andresR8/Robotics4Control/README.md

# Robotics4Control
A mini-sized robot for investigation in robotics and control systems
more info at: http://www.coffeebrain.org/wiki/index.php?title=Robotics_4_Control
