andresR8/Robotics4Control/HardwareFiles/3D/Sensors.stl

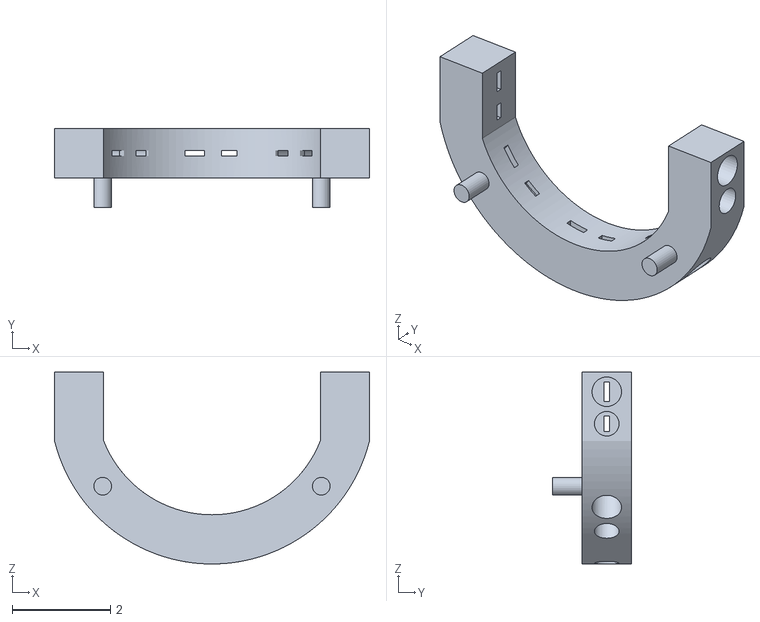
[picture p1: CAD file, 2016-05-07]
HardwareFiles/3D/Sensors.stl
6.40 x 1.60 x 3.90
