andresR8/Robotics4Control/HardwareFiles/3D/MotorHolder.stl

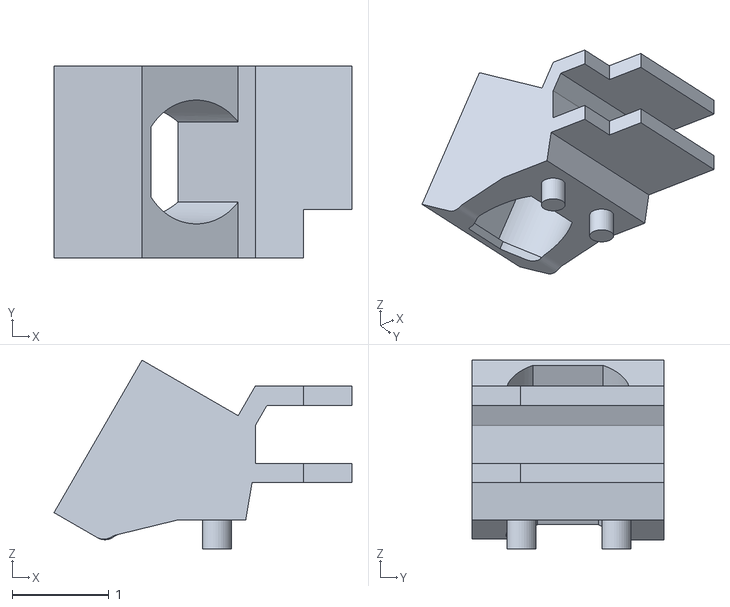
[picture p2: CAD file, 2016-05-07]
HardwareFiles/3D/MotorHolder.stl
3.08 x 1.99 x 1.95
