andresR8/Robotics4Control/HardwareFiles/3D/MotorHolder_MIR.stl

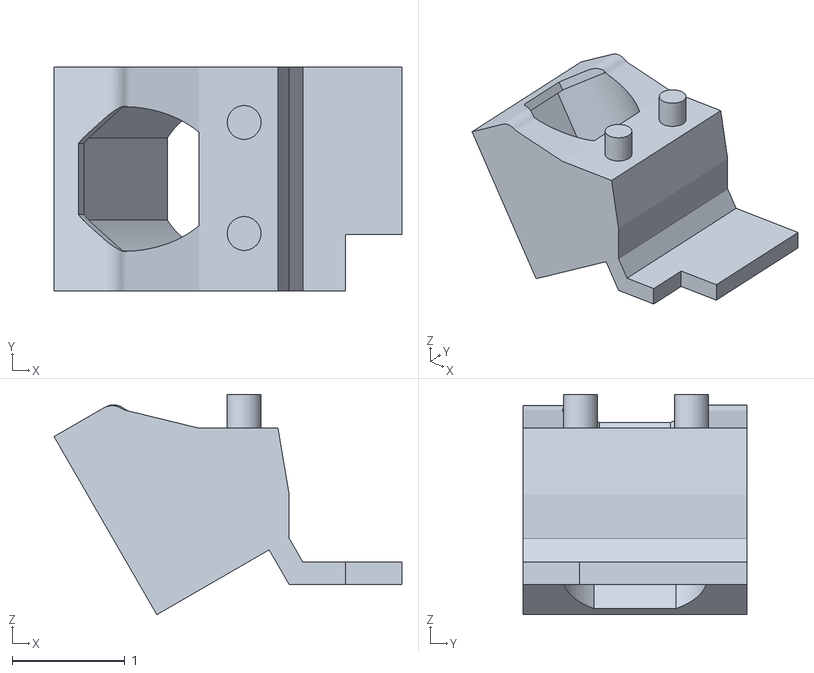
[picture p3: CAD file, 2016-05-07]
HardwareFiles/3D/MotorHolder_MIR.stl
3.08 x 1.99 x 1.95
