andresR8/Robotics4Control/SoftwareFiles/Programmer/install1.PNG

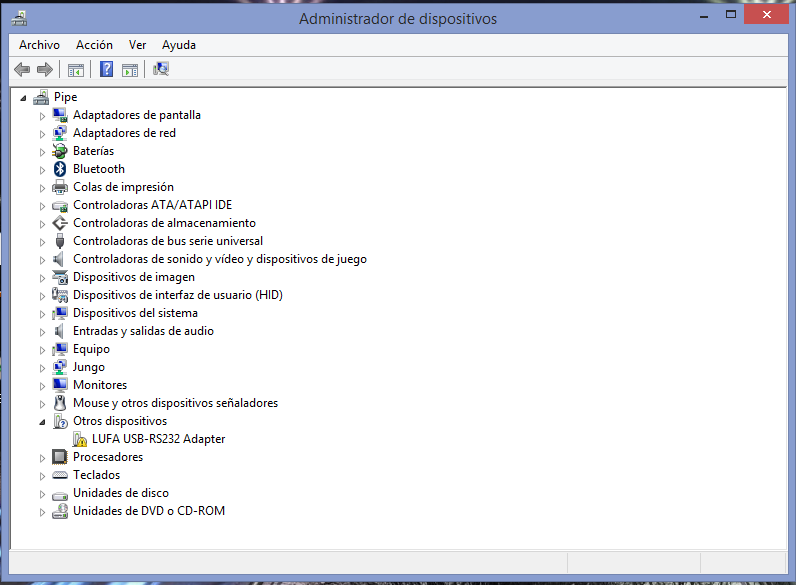
SoftwareFiles/Programmer/install1.PNG
