andresR8/Robotics4Control/SoftwareFiles/Programmer/install2.PNG

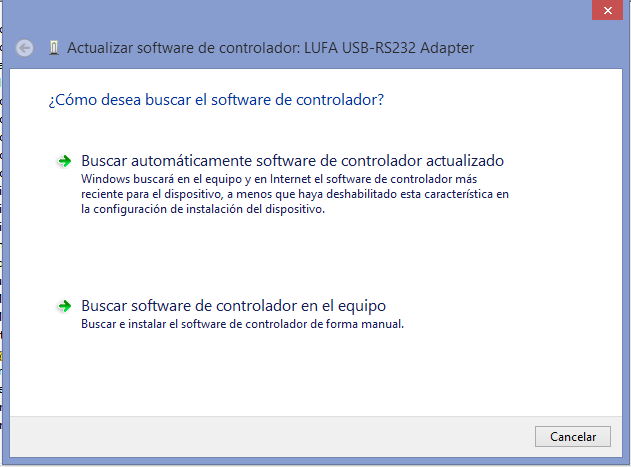
SoftwareFiles/Programmer/install2.PNG
