andresR8/Robotics4Control/SoftwareFiles/Programmer/install3.PNG

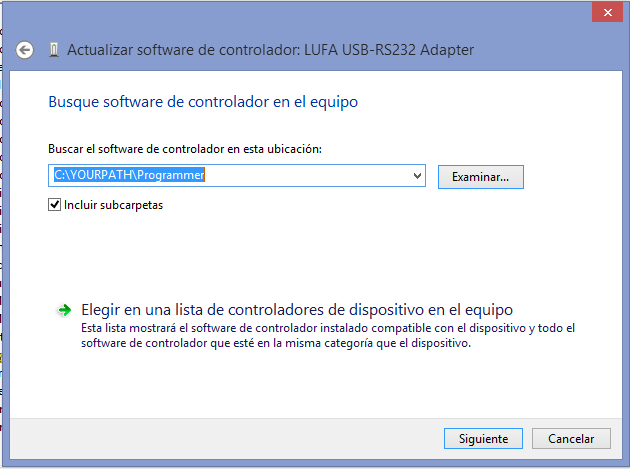
SoftwareFiles/Programmer/install3.PNG
