andresR8/Robotics4Control/SoftwareFiles/Programmer/install4.PNG

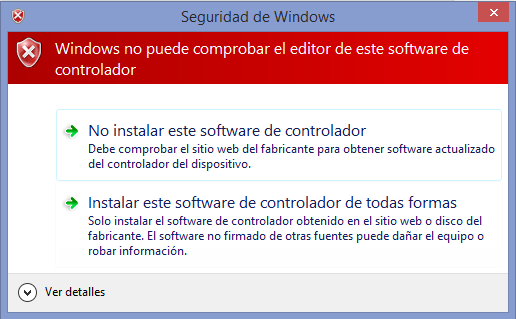
SoftwareFiles/Programmer/install4.PNG
