andresR8/Robotics4Control/SoftwareFiles/Programmer/install5.PNG

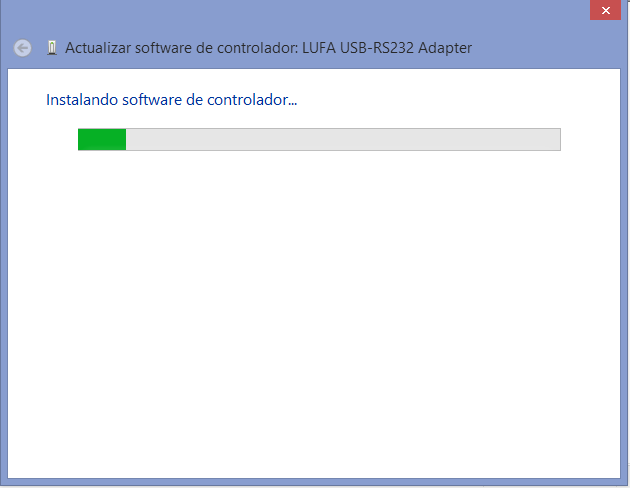
SoftwareFiles/Programmer/install5.PNG
