andresR8/Robotics4Control/SoftwareFiles/Programmer/install6.PNG

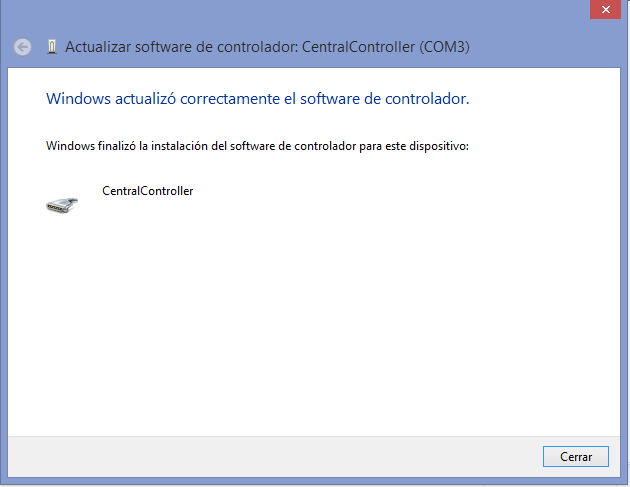
SoftwareFiles/Programmer/install6.PNG
