andresR8/Robotics4Control/SoftwareFiles/Programmer/install7.PNG

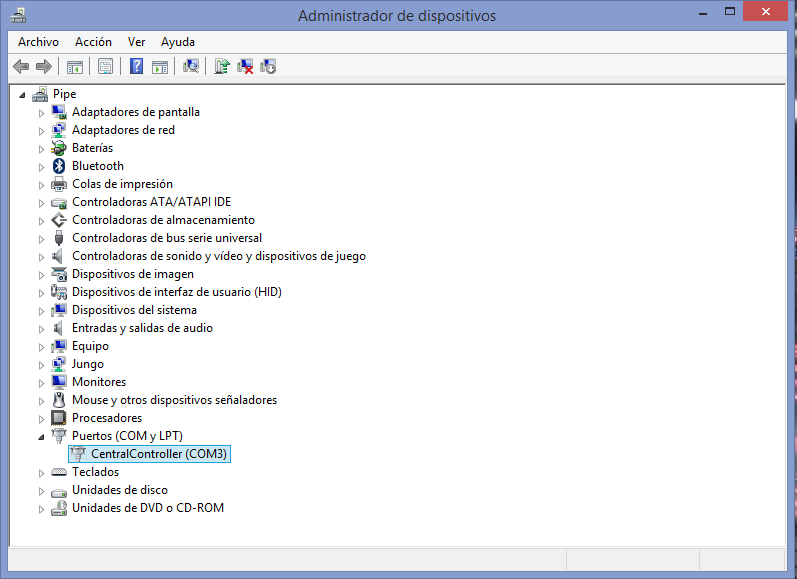
SoftwareFiles/Programmer/install7.PNG
