andresR8/Robotics4Control/HardwareFiles/MainBoard/MainBoardSch.pdf

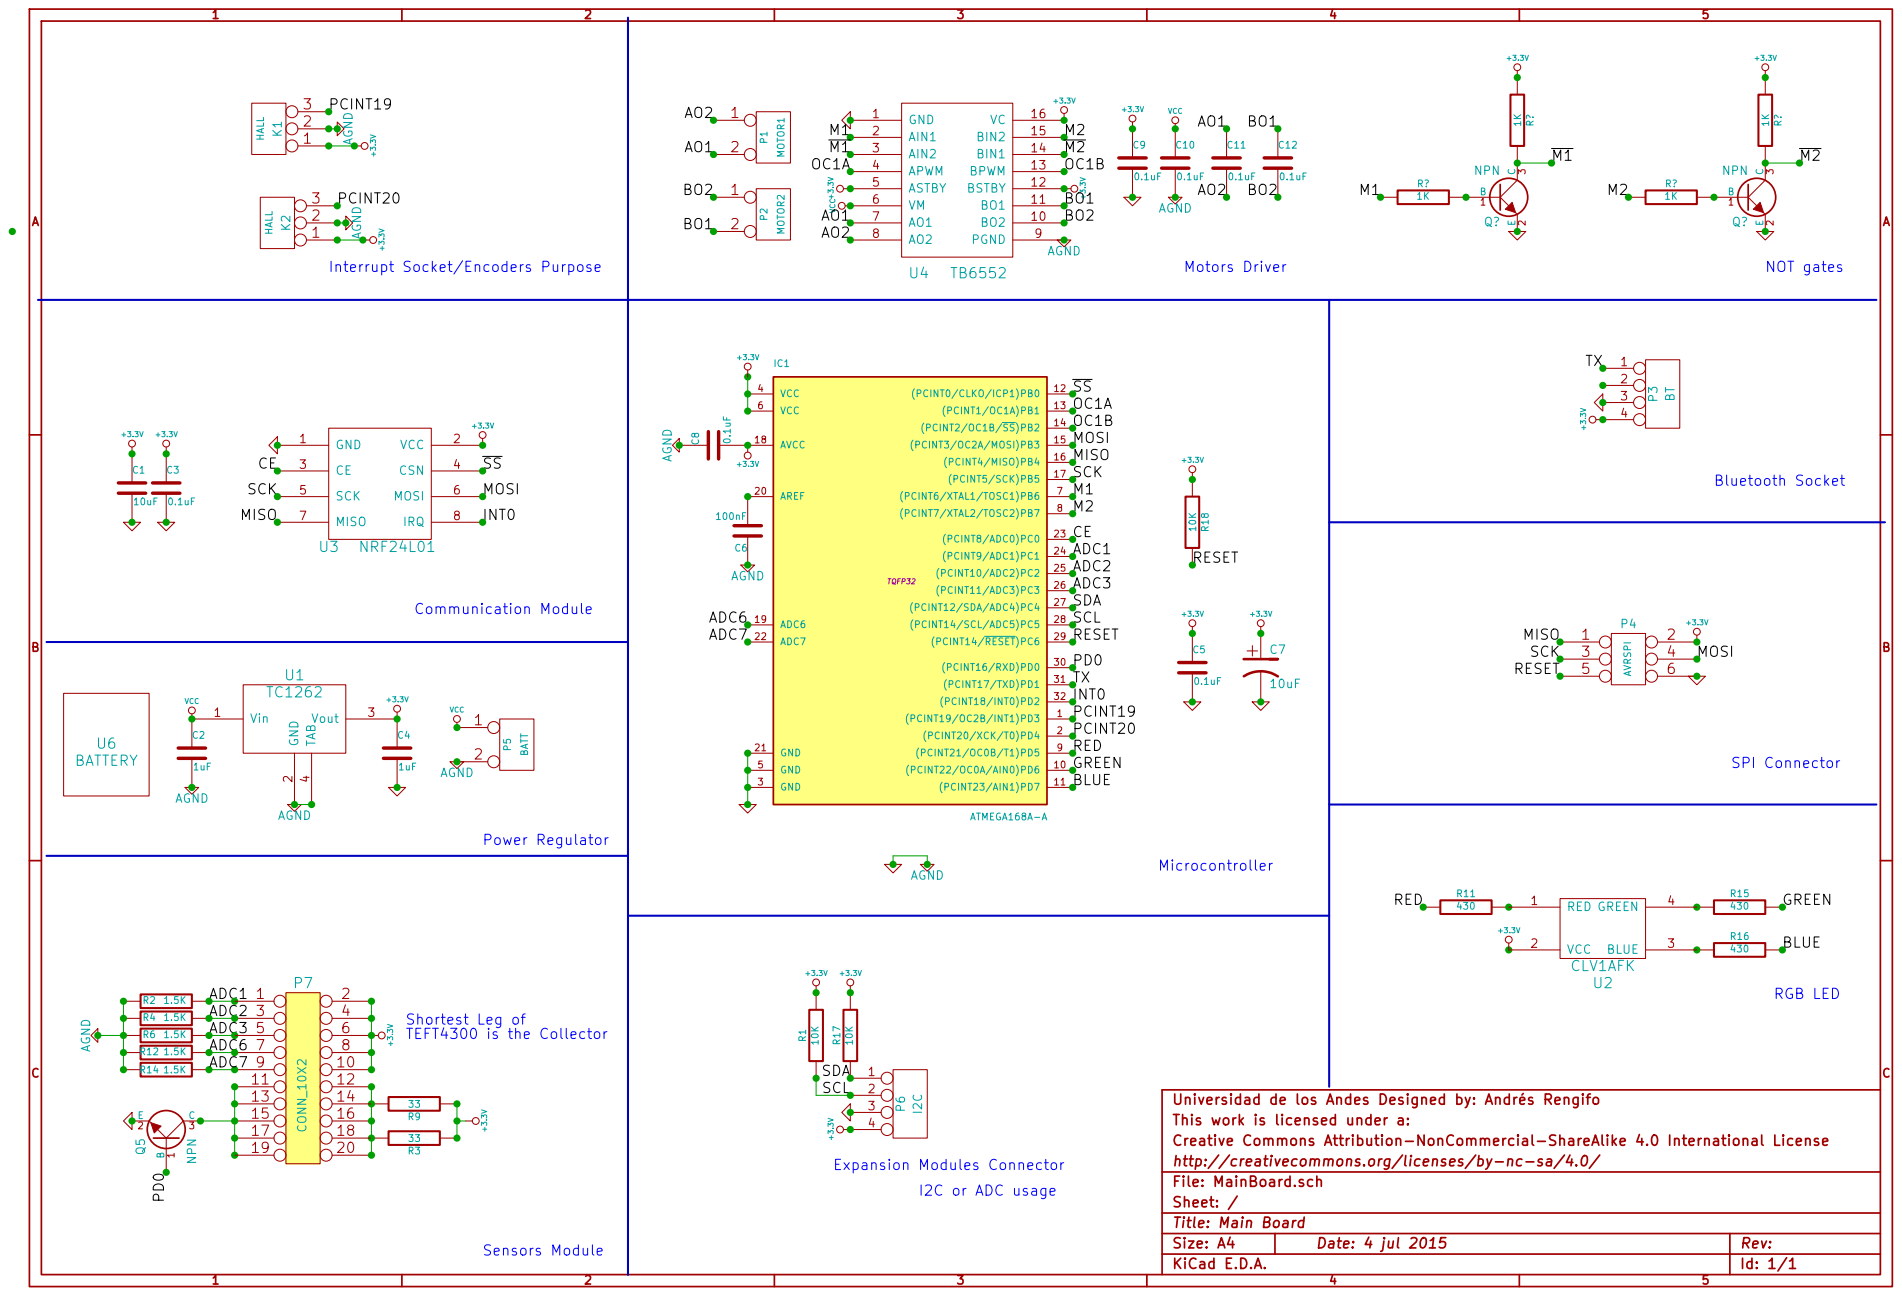
[picture p11: page 1]

4 U1 TC1262 GND 1 AIN1 2 AIN2 3 APWM 4 ASTBY 5 VM 6 AO1 7 AO2 8 PGND 9 BO2 10 BO1 11 BSTBY 12 BPWM 13 BIN1 14 BIN2 15 VC 16 U4 TB6552

Interrupt Socket/Encoders Purpose

ADC2 3 | 4
ADC3 5 | 6
ADC6 7 | 8
9 | 10

Creative Commons Attribution-NonCommercial-ShareAlike 4.0 International License This work is licensed under a: Universidad de los Andes Designed by: Andrés Rengifo

http://creativecommons.org/licenses/by-nc-sa/4.0/
Id: 1/1 Title: Main Board File: MainBoard.sch Sheet: /
