andresR8/Robotics4Control/HardwareFiles/CentralControllerBoard/ProgramerSch.pdf

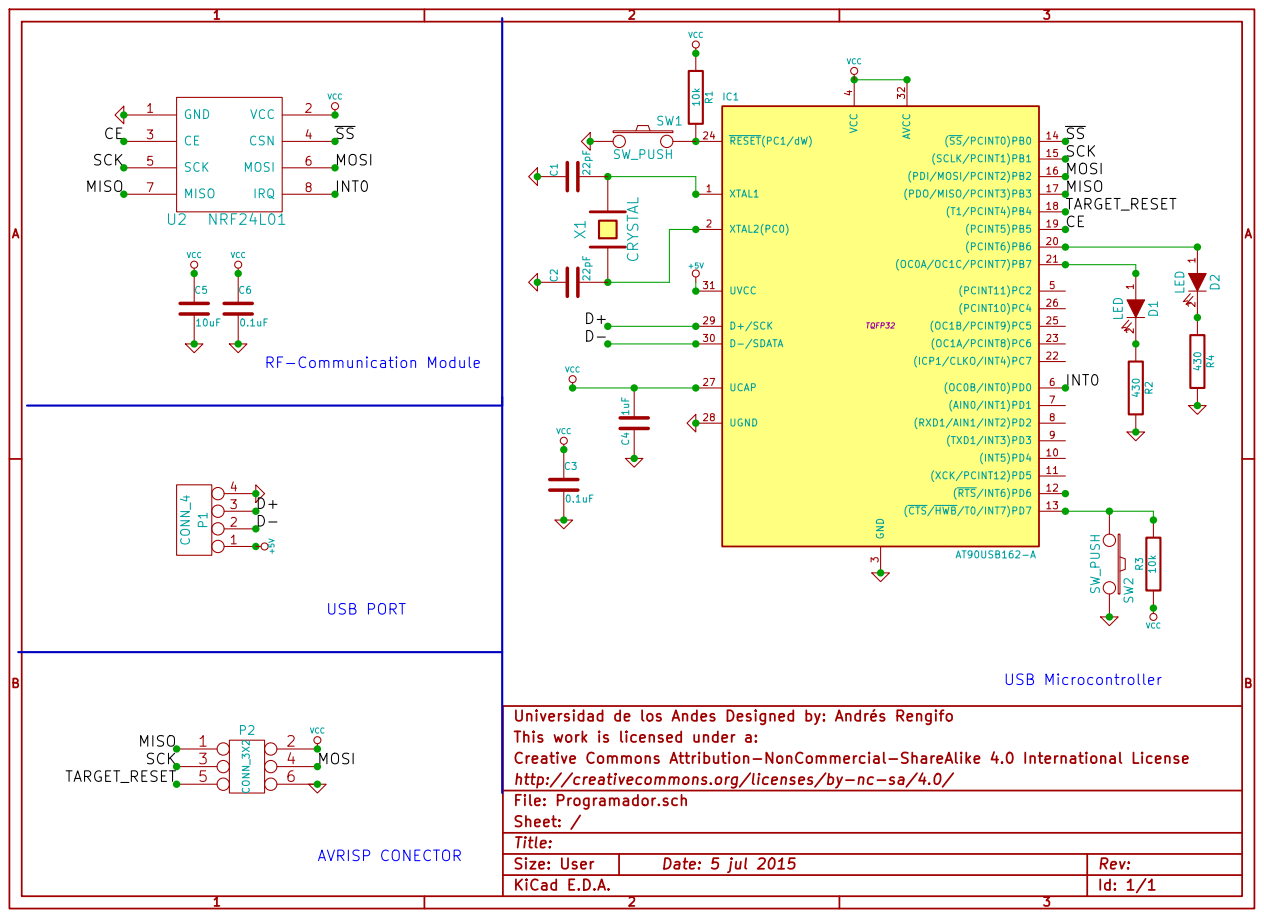
[picture p12: page 1]

1 2 D2 LED 430 R4 R3 10k VCC 1 2 D1 LED 430 R2 +5V X1 CRYSTAL C122pF C222pF

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

http://creativecommons.org/licenses/by-nc-sa/4.0/
Id: 1/1 Title: File: Programador.sch
Sheet: /

Size: User | | Rev:
KiCad E.D.A.
