andresR8/Robotics4Control/HardwareFiles/LipoCharger/ChargerBrd.pdf

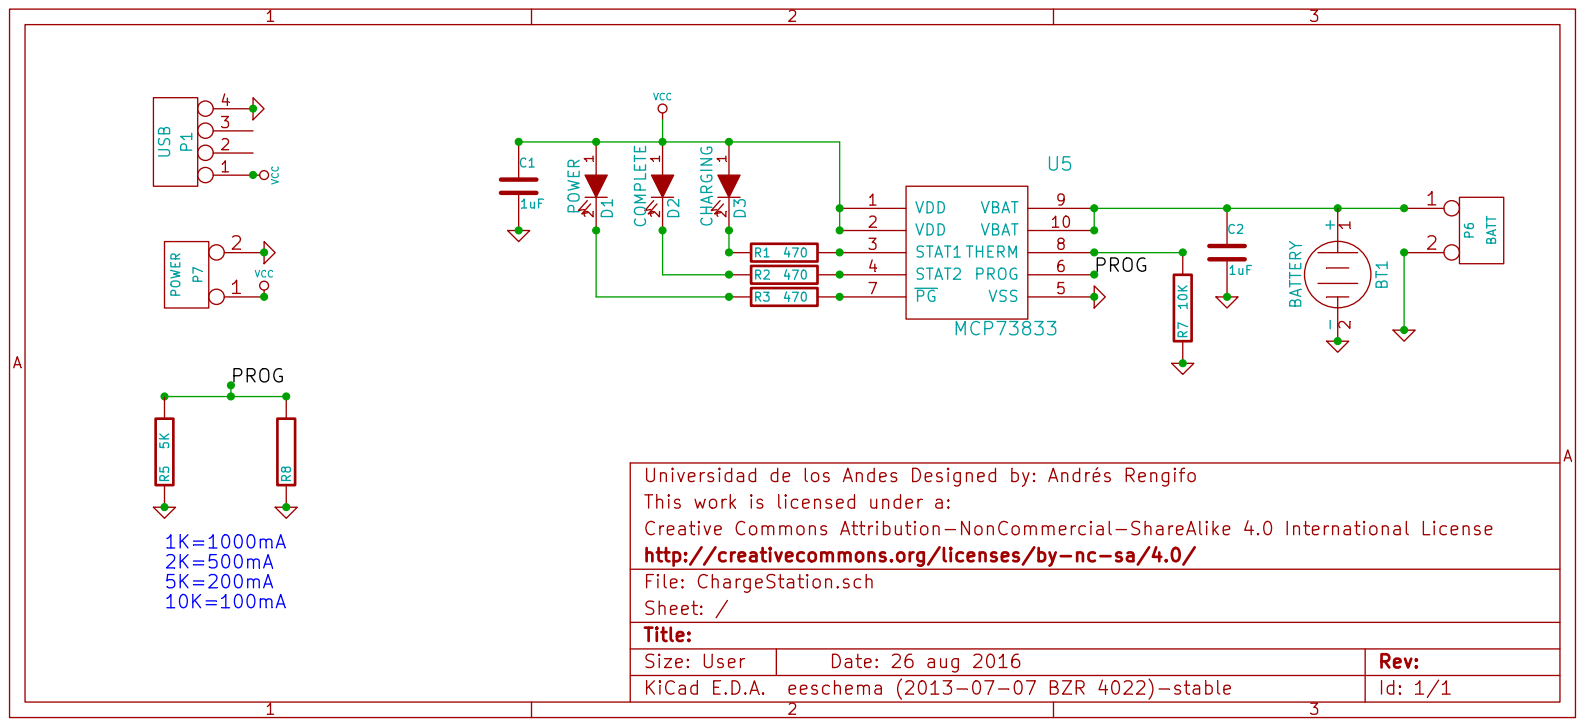
[picture p13: page 1]
