andresR8/Robotics4Control/HardwareFiles/MainBoard/MainBoardBackBrd.pdf

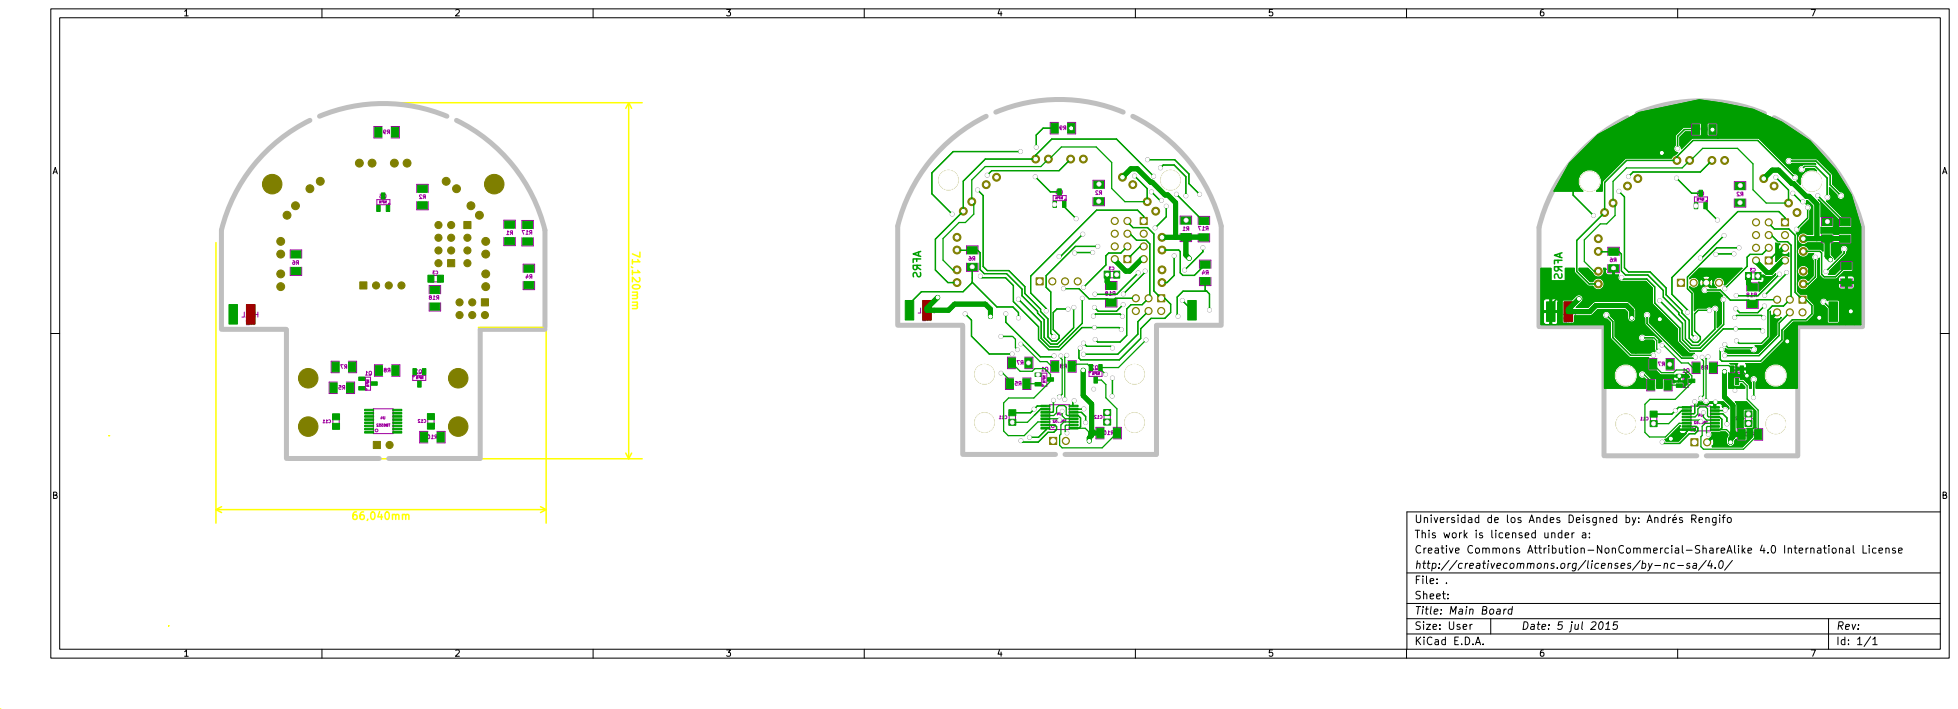
[picture p14: page 1]
