andresR8/Robotics4Control/HardwareFiles/MainBoard/MainBoardFrontBrd.pdf

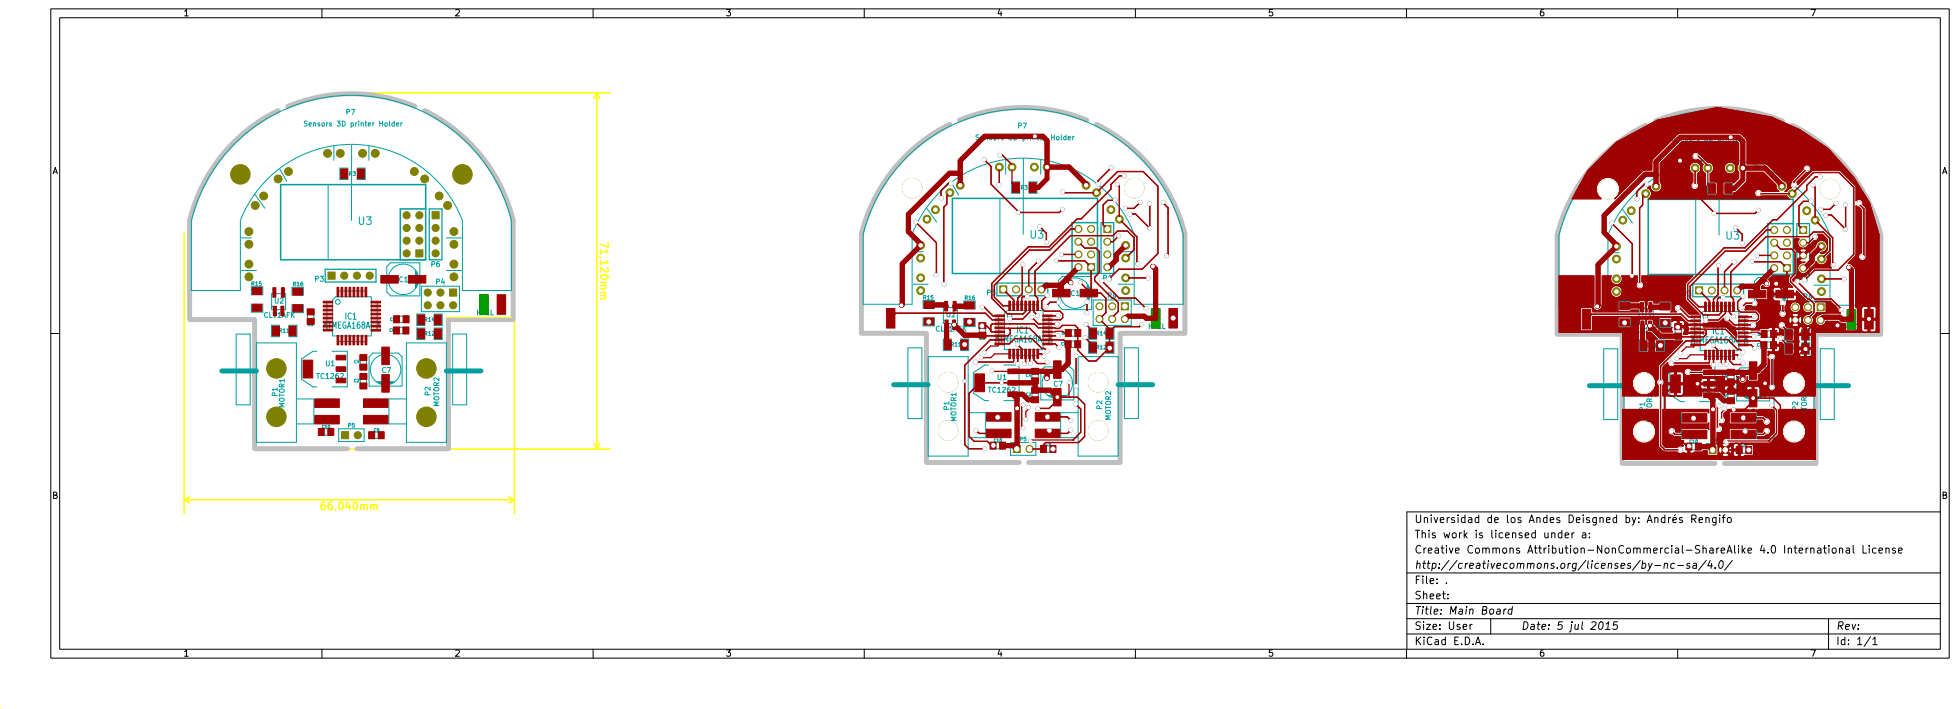
[picture p15: page 1]
