andresR8/Robotics4Control/HardwareFiles/CentralControllerBoard/ProgramerBrdBack.pdf

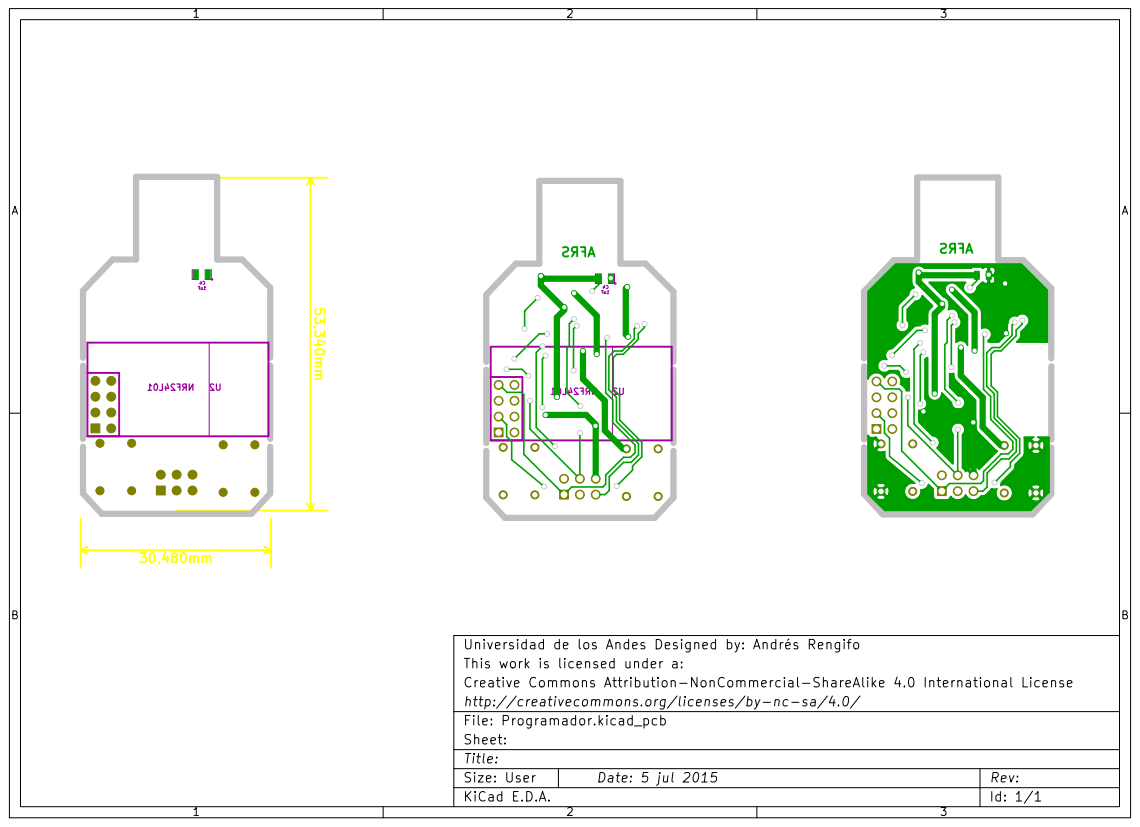
[picture p16: page 1]
