andresR8/Robotics4Control/HardwareFiles/CentralControllerBoard/ProgramerBrdFront.pdf

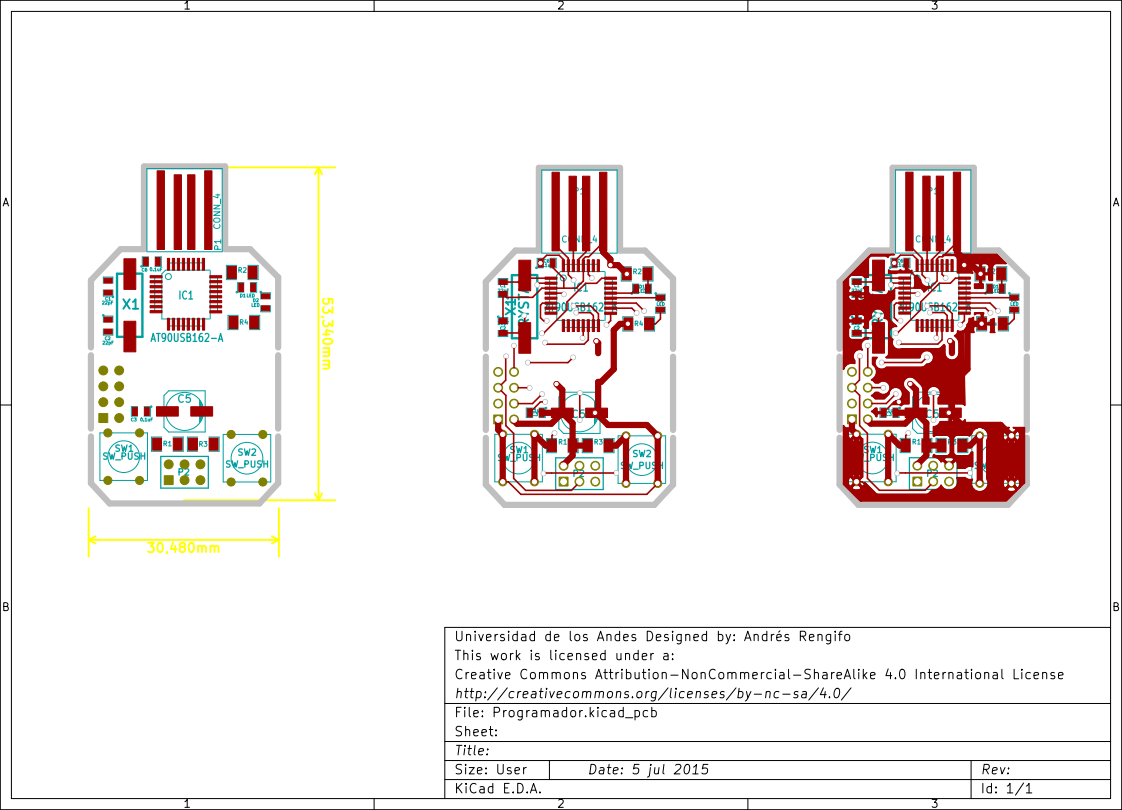
[picture p17: page 1]
