andresR8/Robotics4Control/HardwareFiles/LipoCharger/ChargeStation.kicad_pcb

## KiCad design HardwareFiles/LipoCharger/ChargeStation.kicad_pcb (2016-08-26)

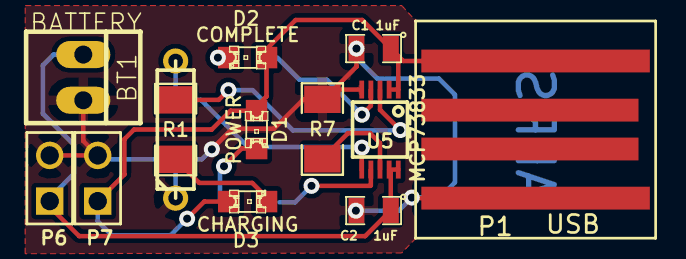
[picture p18: board ChargeStation.kicad_pcb from above]

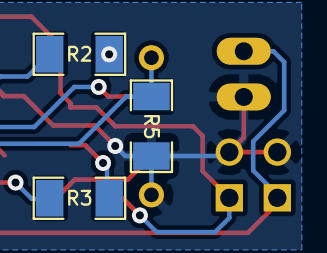
[picture p19: board ChargeStation.kicad_pcb from below]

Board: 2 copper layers, 16 parts (3 on the bottom side), 11 nets.

Parts:
BT1: BATTERY; PINHEAD1-2
C1, C2: 1uF; SM0805
D1: POWER; LED-0805
D2: COMPLETE; LED-0805
D3: CHARGING; LED-0805
P1: USB; USB_A_SMD
P6: BATT; PIN_ARRAY_2X1
P7: POWER; PIN_ARRAY_2X1
R1, R2, R3: 470; SM1206
R5: 5K; SM1206
R7: 10K; SM1206
R8: R3
U5: MCP73833; MSOP10-0.5

Connections:
/PROG: R5.2, R8.2, U5.6
GND: BT1.2, C1.2, C2.2, P1.4, P6.2, P7.2, R5.1, R7.1, R8.1, U5.5
unnamed: D2.2, R2.1
unnamed: D1.2, R3.1
unnamed: D3.2, R1.1
unnamed: R3.2, U5.7
unnamed: R1.2, U5.3
unnamed: R2.2, U5.4
unnamed: R7.2, U5.8
unnamed: BT1.1, C2.1, P6.1, U5.9, U5.10
VCC: C1.1, D1.1, D2.1, D3.1, P1.1, P7.1, U5.1, U5.2
