andresR8/Robotics4Control/HardwareFiles/CentralControllerBoard/Programador.kicad_pcb

## KiCad design HardwareFiles/CentralControllerBoard/Programador.kicad_pcb (2016-08-26)

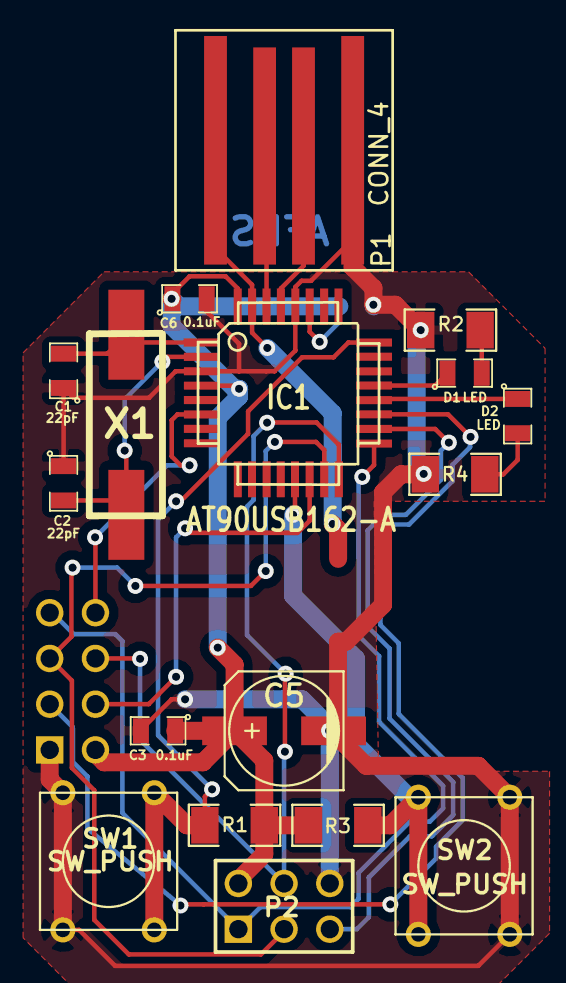
[picture p20: board Programador.kicad_pcb from above]

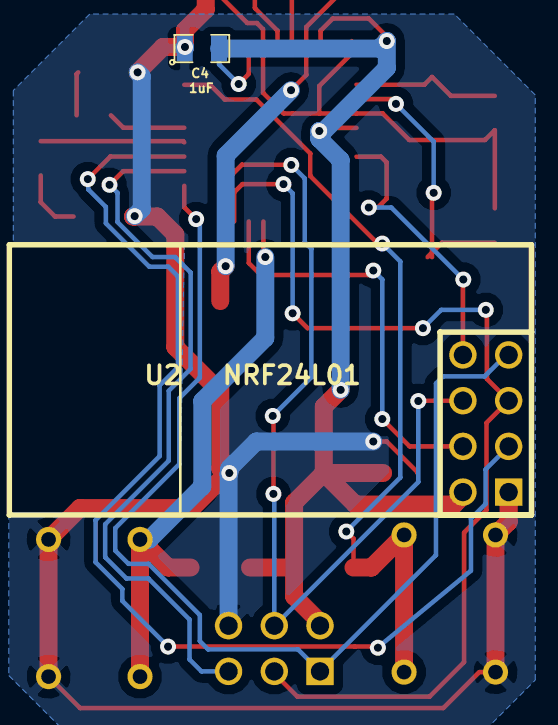
[picture p21: board Programador.kicad_pcb from below]

Board: 2 copper layers, 19 parts (2 on the bottom side), 20 nets.

Parts:
C1, C2: 22pF; SM0805
C3, C6: 0.1uF; SM0805
C4: 1uF; SM0805
C5: 10uF; c_elec_6.3x5.3
D1, D2: LED; SM0805
IC1: AT90USB162-A; TQFP32
P1: CONN_4; USB_A_SMD
P2: CONN_3X2; pin_array_3x2
R1, R3: 10k; SM1206
R2, R4: 430; SM1206
SW1, SW2: SW_PUSH; SW_PUSH_SMALL
U2   NRF24L01: NRF24L01; Nrf24l01
X1: crystals

Connections:
+5V: IC1.31, P1.1
/CE: IC1.19, U2 NRF24L01.3
/D+: IC1.29, P1.3
/D-: IC1.30, P1.2
/INT0: IC1.6, U2 NRF24L01.8
/MISO: IC1.17, P2.1, U2 NRF24L01.7
/MOSI: IC1.16, P2.4, U2 NRF24L01.6
/SCK: IC1.15, P2.3, U2 NRF24L01.5
/TARGET_RESET: IC1.18, P2.5
/~SS: IC1.14, U2 NRF24L01.4
GND: C1.1, C2.1, C3.2, C4.1, C5.2, C6.2, IC1.3, IC1.28, P1.4, P2.6, R2.2, R4.2, SW1.1, SW2.2, U2 NRF24L01.1
unnamed: D2.2, R4.1
unnamed: D2.1, IC1.20
unnamed: C2.2, IC1.2, X1.1
unnamed: C1.2, IC1.1, X1.2
unnamed: D1.2, R2.1
unnamed: D1.1, IC1.21
unnamed: IC1.24, R1.2, SW1.2
unnamed: IC1.13, R3.2, SW2.1
VCC: C3.1, C4.2, C5.1, C6.1, IC1.4, IC1.27, IC1.32, P2.2, R1.1, R3.1, U2 NRF24L01.2
