andresR8/Robotics4Control/HardwareFiles/MainBoard/MainBoard.kicad_pcb

## KiCad design HardwareFiles/MainBoard/MainBoard.kicad_pcb (2016-08-24)

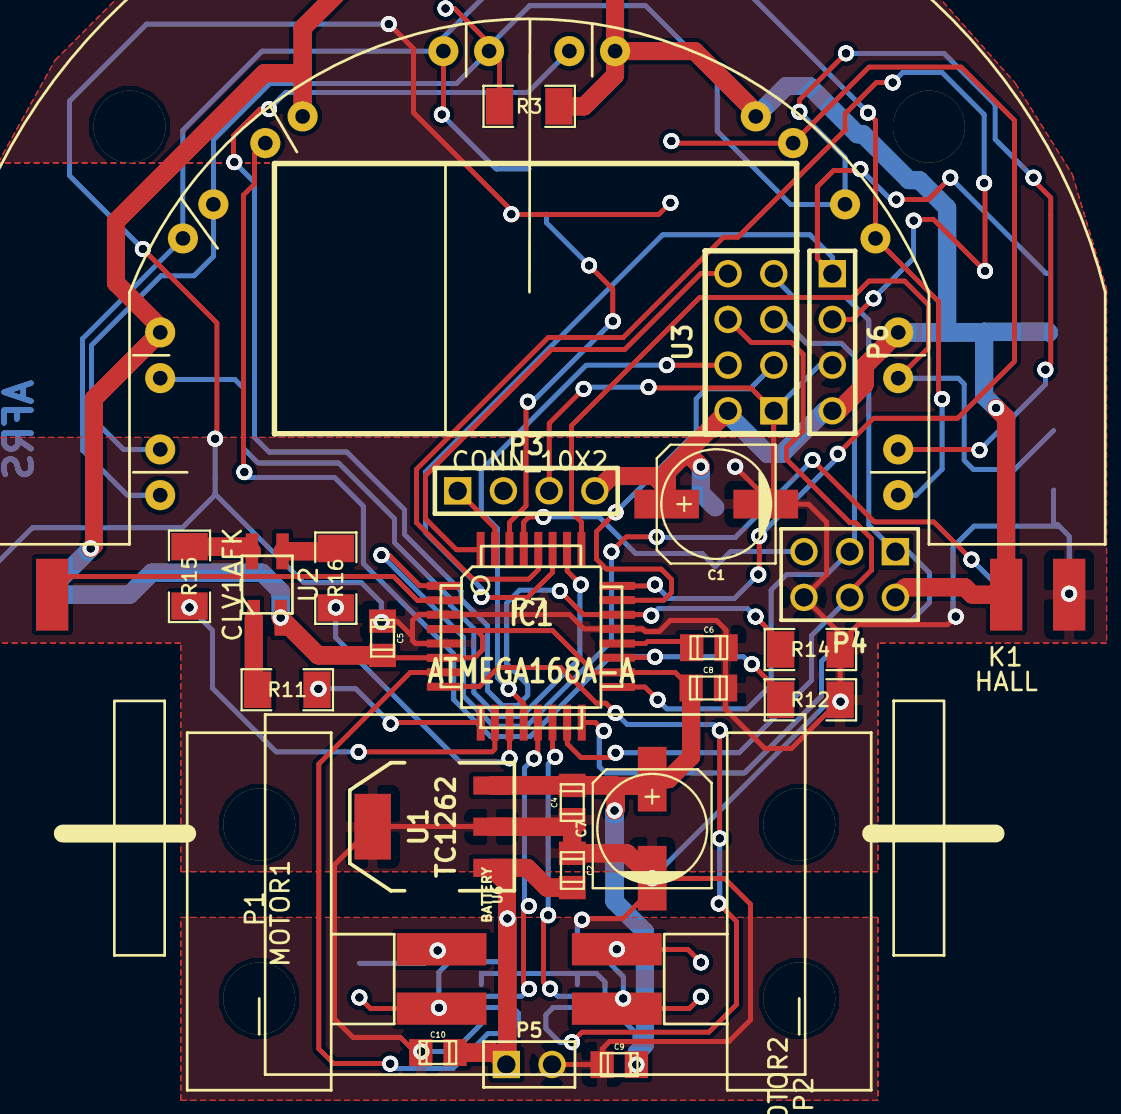
[picture p22: board MainBoard.kicad_pcb from above]

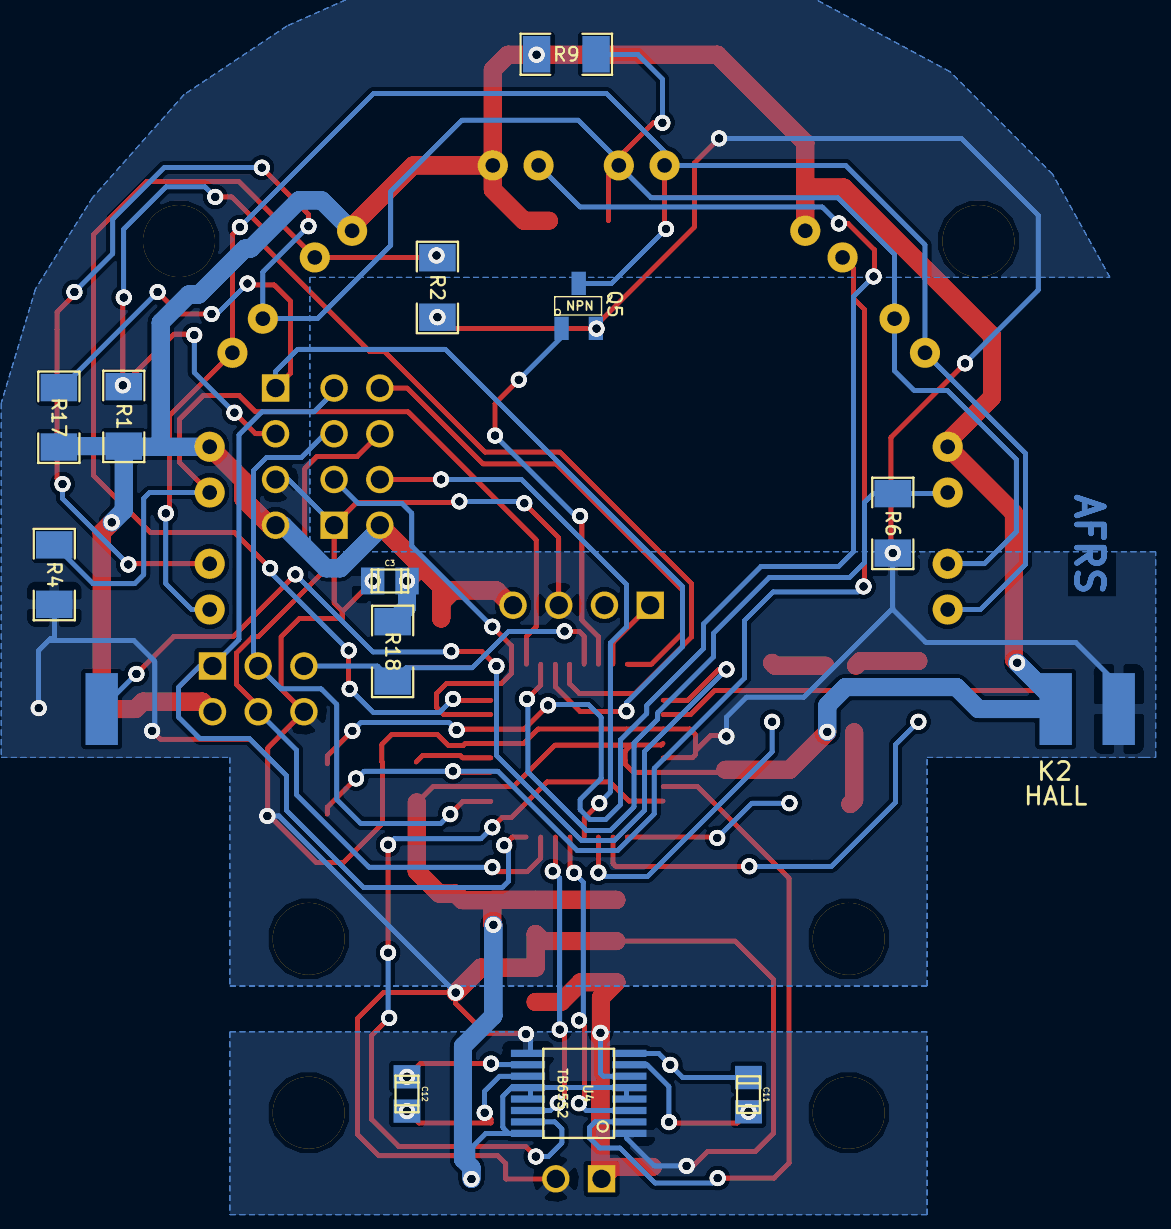
[picture p23: board MainBoard.kicad_pcb from below]

Board: 2 copper layers, 41 parts (13 on the bottom side), 38 nets.

Parts:
C1, C7: 10uF; c_elec_6.3x5.3
C2, C4: 1uF; c_0805
C3, C5, C8, C9, C10, C11, C12: 0.1uF; c_0805
C6: 100nF; c_0805
IC1: ATMEGA168A-A; TQFP32
K1, K2: HALL
P1: MOTOR1; MotorLeft
P2: MOTOR2; MotorRight
P3: BT; PIN_ARRAY_4x1
P4: AVRSPI; pin_array_3x2
P5: BATT; PIN_ARRAY_2X1
P6: I2C; PIN_ARRAY_4x1
P7: CONN_10X2; IR_Sensors
Q5: NPN; SOT23_MOD
R1, R17, R18: 10K; SM1206
R2, R4, R6, R12, R14: 1.5K; SM1206
R3, R9: 33; SM1206
R11, R15, R16: 430; SM1206
U1: TC1262; SOT223
U2: CLV1AFK; LEDRGB
U3: NRF24L01; Nrf24l01
U4: TB6552; ssop_16
U6: BATTERY; Battery3x2

Connections:
+3.3V: C1.1, C3.1, C4.1, C5.1, C7.1, C8.2, C9.1, IC1.4, IC1.6, IC1.18, K1.1, K2.1, P3.4, P4.2, P6.4, P7.2, P7.4, P7.6, P7.8, P7.10, R1.2, R3.1, R9.1, R17.2, R18.1, U1.3, U2.2, U3.2, U4.4, U4.5, U4.12, U4.13, U4.16
/ADC1: IC1.24, P7.1, R2.1
/ADC2: IC1.25, P7.3, R4.1
/ADC3: IC1.26, P7.5, R6.1
/ADC6: IC1.19, P7.7, R12.1
/ADC7: IC1.22, P7.9, R14.2
/AO1: C11.1, P1.2, U4.7
/AO2: C11.2, P1.1, U4.8
/BLUE: IC1.11, R16.2
/BO1: C12.1, P2.2, U4.11
/BO2: C12.2, P2.1, U4.10
/CE: IC1.23, U3.3
/GREEN: IC1.10, R15.2
/INT0: IC1.32, U3.8
/M1: IC1.7, U4.2
/M2: IC1.8, U4.15
/MISO: IC1.16, P4.1, U3.7
/MOSI: IC1.15, P4.4, U3.6
/OC1A: IC1.13, U4.3
/OC1B: IC1.14, U4.14
/PCINT19: IC1.1, K1.3
/PCINT20: IC1.2, K2.3
/PD0: IC1.30, Q5.1
/RED: IC1.9, R11.1
/RESET: IC1.29, P4.5, R18.2
/SCK: IC1.17, P4.3, U3.5
/SCL: IC1.28, P6.2, R1.1
/SDA: IC1.27, P6.1, R17.1
/TX: IC1.31, P3.1
/~SS: IC1.12, U3.4
AGND: C1.2, C2.2, C3.2, C4.2, C5.2, C6.1, C7.2, C8.1, C9.2, C10.2, IC1.3, IC1.5, IC1.21, K1.2, K2.2, P3.3, P4.6, P5.2, P6.3, Q5.2, R2.2, R4.2, R6.2, R12.2, R14.1, U1.2, U1.4, U3.1, U4.1, U4.9
unnamed: P7.11, P7.13, P7.15, P7.17, P7.19, Q5.3
unnamed: P7.12, P7.14, P7.16, P7.18, P7.20, R3.2, R9.2
unnamed: R11.2, U2.1
unnamed: R16.1, U2.3
unnamed: R15.1, U2.4
unnamed: C6.2, IC1.20
VCC: C2.1, C10.1, P5.1, U1.1, U4.6
