andresR8/Robotics4Control/HardwareFiles/CentralControllerBoard/Programador.sch

## KiCad design HardwareFiles/CentralControllerBoard/Programador.sch (2016-08-26)

Schematic: Programador.sch

Parts:
C1, C2: 22pF
C3, C6: 0.1uF
C4: 1uF
C5: 10uF
D1, D2: LED
IC1: AT90USB162-A; TQFP32
P1: CONN_4
P2: CONN_3X2
R1, R3: 10k
R2, R4: 430
SW1, SW2: SW_PUSH
U2: NRF24L01
X1: CRYSTAL

Notes on the sheet:
AVRISP CONECTOR
USB PORT
RF-Communication Module
USB Microcontroller
