andresR8/Robotics4Control/HardwareFiles/LipoCharger/ChargeStation.sch

## KiCad design HardwareFiles/LipoCharger/ChargeStation.sch (2016-08-26)

Schematic: ChargeStation.sch

Parts:
BT1: BATTERY
C1, C2: 1uF
D1: POWER
D2: COMPLETE
D3: CHARGING
P1: USB
P6: BATT
P7: POWER
R1, R2, R3: 470
R5: 5K
R7: 10K
R8: (no value)
U5: MCP78833

Notes on the sheet:
1K=1000mA 2K=500mA 5K=200mA 10K=100mA
