andresR8/Robotics4Control/HardwareFiles/MainBoard/MainBoard.sch

## KiCad design HardwareFiles/MainBoard/MainBoard.sch (2016-08-24)

Schematic: MainBoard.sch

Parts:
C1, C7: 10uF
C2, C4: 1uF
C3, C5, C8, C9, C10, C11, C12: 0.1uF
C6: 100nF
IC1: ATMEGA168A-A; TQFP32
K1, K2: HALL
P1: MOTOR1
P2: MOTOR2
P3: BT
P4: AVRSPI
P5: BATT
P6: I2C
P7: CONN_10X2
Q5: NPN
R1, R17, R18: 10K
R2, R4, R6, R12, R14: 1.5K
R3, R9: 33
R11, R15, R16: 430
U1: TC1262
U2: CLV1AFK
U3: NRF24L01
U4: TB6552
U6: BATTERY

Notes on the sheet:
Shortest Leg of TEFT4300 is the Collector
For PCB sizing purposes
