andresR8/Robotics4Control/(commit log)

2016-05-07 3D Printed parts
    [MotorHolder.stl, MotorHolder_MIR.stl, Sensors.stl]
2016-05-07 Central Controller electronic board design
    [Programador.brd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]
2016-05-07 Lipo Charger electronic board design
    [Charger.drl]
2016-05-07 Robot Main Board design
    [MainBoard.brd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]
2016-05-07 USB LUFA Drivers
2016-08-24 BOM file added
    [BOM.csv]
2016-08-24 new kicad board format
    [MainBoard.kicad_pcb]
2016-08-24 Remove legacy kicad file
    [MainBoard.brd]
2016-08-24 gerber files updated
    [MainBoard.brd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]
2016-08-24 Schematic File added
    [MainBoard.sch]
2016-08-24 BOM file completed
    [BOM.csv]
2016-08-26 Board & Schematic File added
    [Programador.kicad_pcb, Programador.sch]
2016-08-26 Kicad design files added
    [ChargeStation.kicad_pcb, ChargeStation.sch]
